wagiminator/ATtiny13-TinyRemoteXL/hardware/TinyRemoteXL_BOM.tsv

ID | Name | Designator | Footprint | Quantity | Manufacturer Part | Manufacturer | Supplier | Supplier Part | Price | JLCPCB Part Class
1 | CR2032-BS-6-1 | B1 | BATTERY-3 | 1 | CR2032-BS-6-1 | Q&J | LCSC | C70377 | 0.1908
2 | 100n | C1 | 0603 | 1 | CC0603KRX7R9BB104 | YAGEO | LCSC | C14663 | 0.0039
3 | BAS16TW | D1,D2,D3,D4 | SOT-363 | 4 | BAS16TW | CJ | LCSC | C68955 | 0.063 | Extended Part
4 | SMD Tactile Switch6*6*6mm | KEY1,KEY2,KEY3,KEY4,KEY5,KEY6,KEY7,KEY8,KEY9,KEY10,KEY11,KEY12 | KEY-6.0*6.0 | 12 | SMD Tactile Switch6*6*6mm | ReliaPro | LCSC | C23873 | 0.019
5 | IR333-A | LED1 | LED-3MM/2.54 | 1 | IR333-A | Everlight Elec | LCSC | C264290 | 0.0632
6 | IR333C/H0/L10 | LED2 | LED-3MM/2.54 | 1 | IR333C/H0/L10 | EVERLIGHT | LCSC | C72053 | 0.0633
7 | 2n3904S | Q1,Q2 | SOT-23-3 | 2 | 2n3904S-RTK/PS | KEC | LCSC | C18536 | 0.0178
8 | 10k | R1,R2,R3 | 0603 | 3 | 0603WAF1002T5E | UniOhm | LCSC | C25804 | 0.0014
9 | 1k | R4,R5 | 0603 | 2 | 0603WAF1001T5E | UniOhm | LCSC | C21190 | 0.0013
10 | 4k7 | R6,R7,R8,R9,R10,R11,R12,R13,R14,R15 | 0603 | 10 | 0603WAF4701T5E | UniOhm | LCSC | C23162 | 0.0014
11 | ATtiny13A | U1 | SOP-8_150MIL | 1 | ATTINY13A-SSU | MICROCHIP | LCSC | C14075 | 0.8349
