wagiminator/ATtiny13-TinyRemoteXL/hardware/TinyRemoteXL_schematic.pdf

# VCC PB⁵

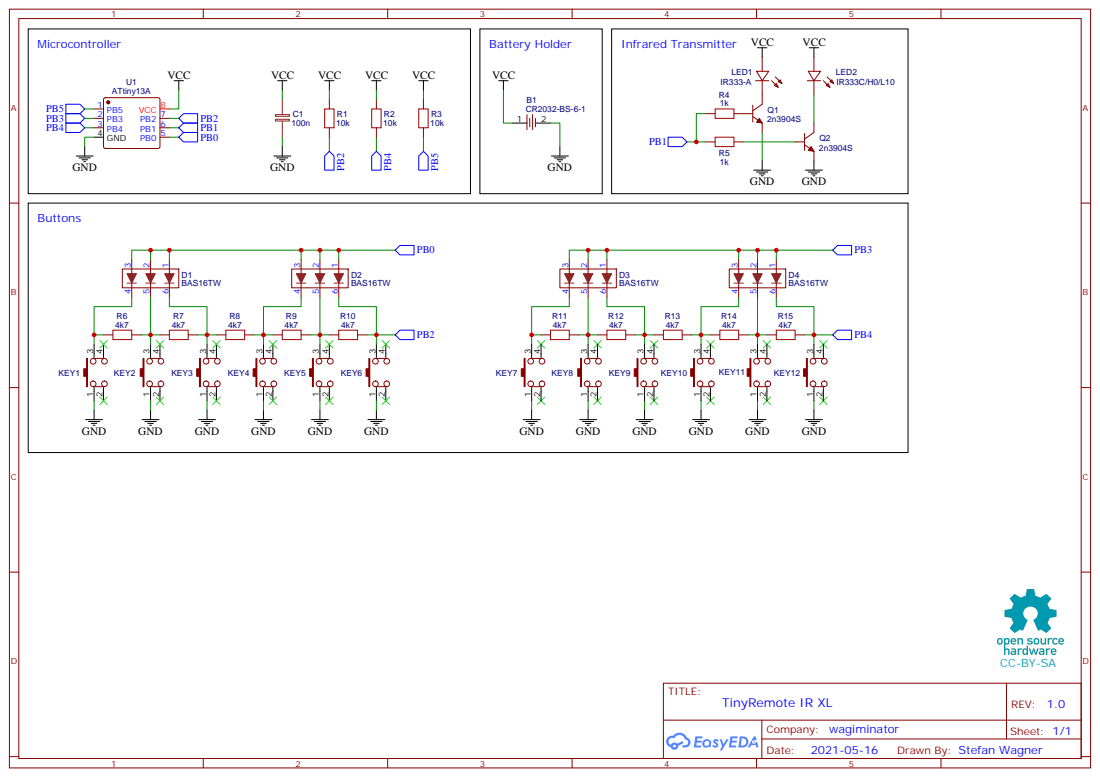
[picture p5: page 1]

Drawn By: Stefan Wagner
